f4goh/aprs-pocket/README.md

# APRS-pocket

**APRS with ATtiny1614**

The goal is to build a low-cost APRS tracker that fits inside a classic pocket format.  
Tracker configuration is done via serial communication using Google Chrome — no app installation required.

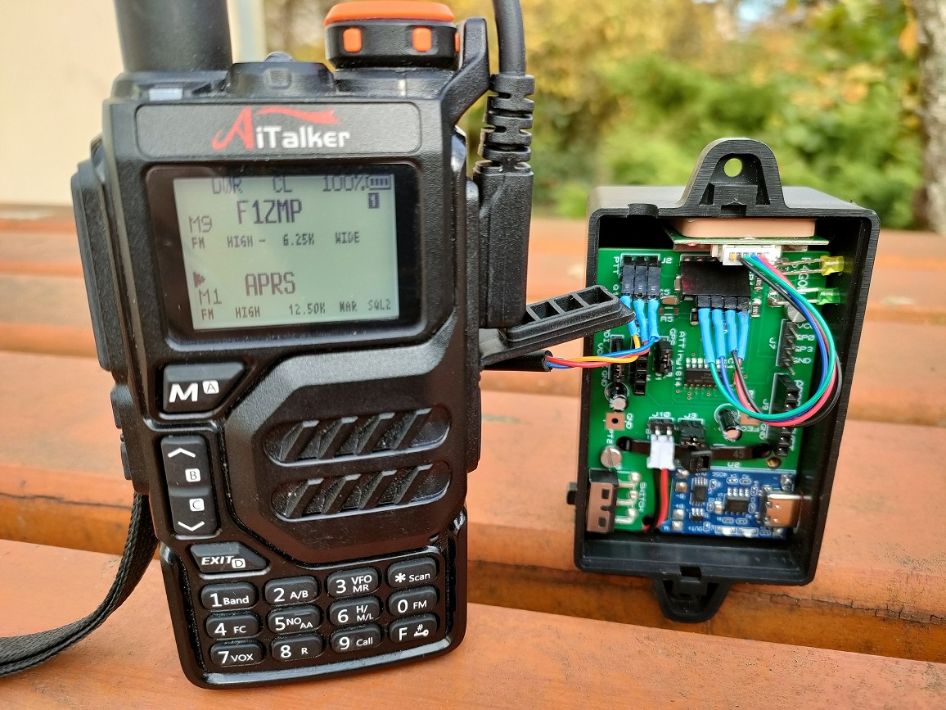
[picture p1: images/ensemble.jpg]
ens


## [APRS POCKET Setup](https://f4goh.github.io/aprs-pocket/)

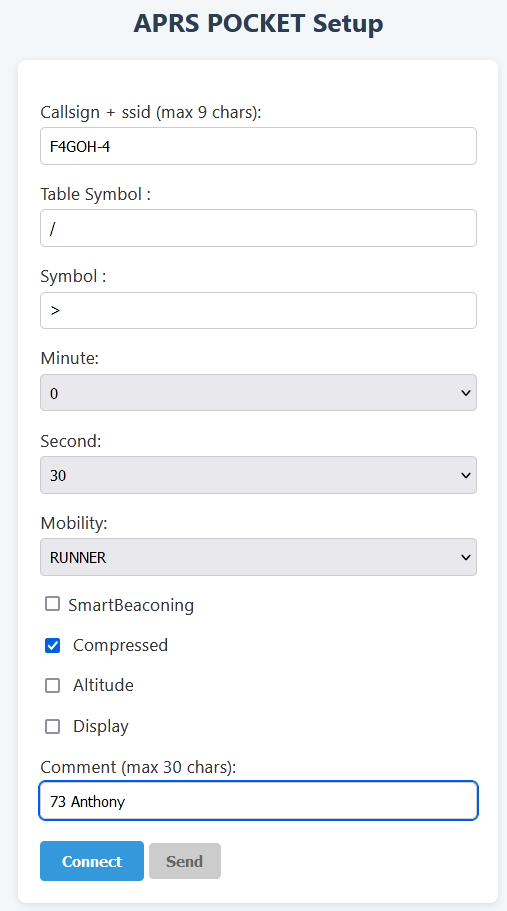
[picture p2: images/config.png]
config


## Schematic

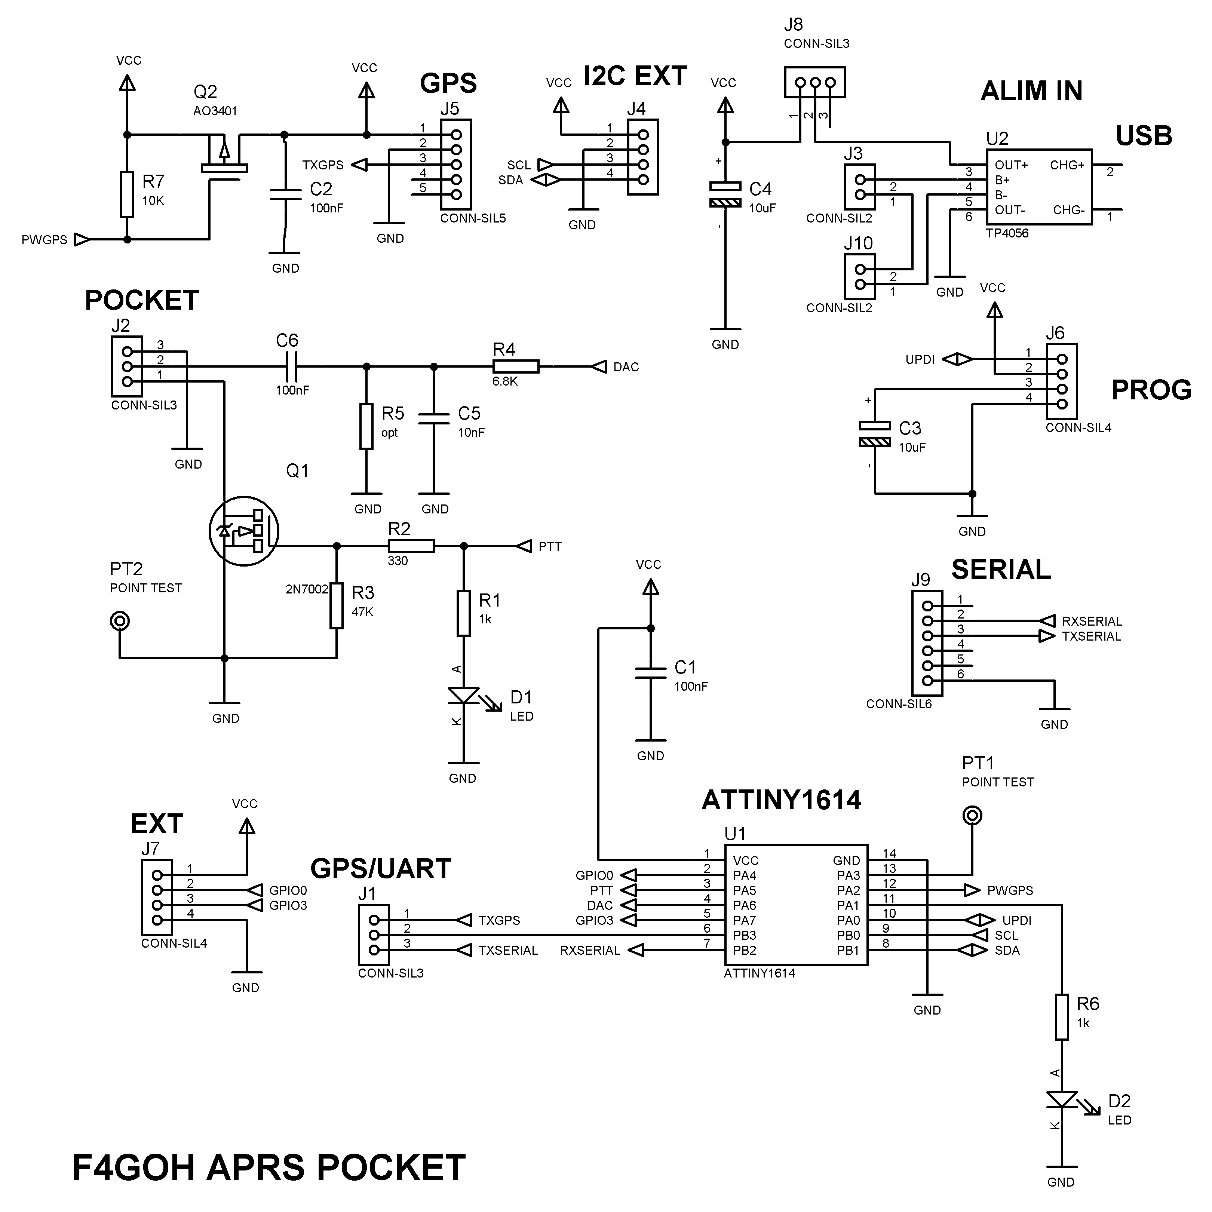
[picture p3: schematics/aprs_pocket.png]
Schematic


## BOARD

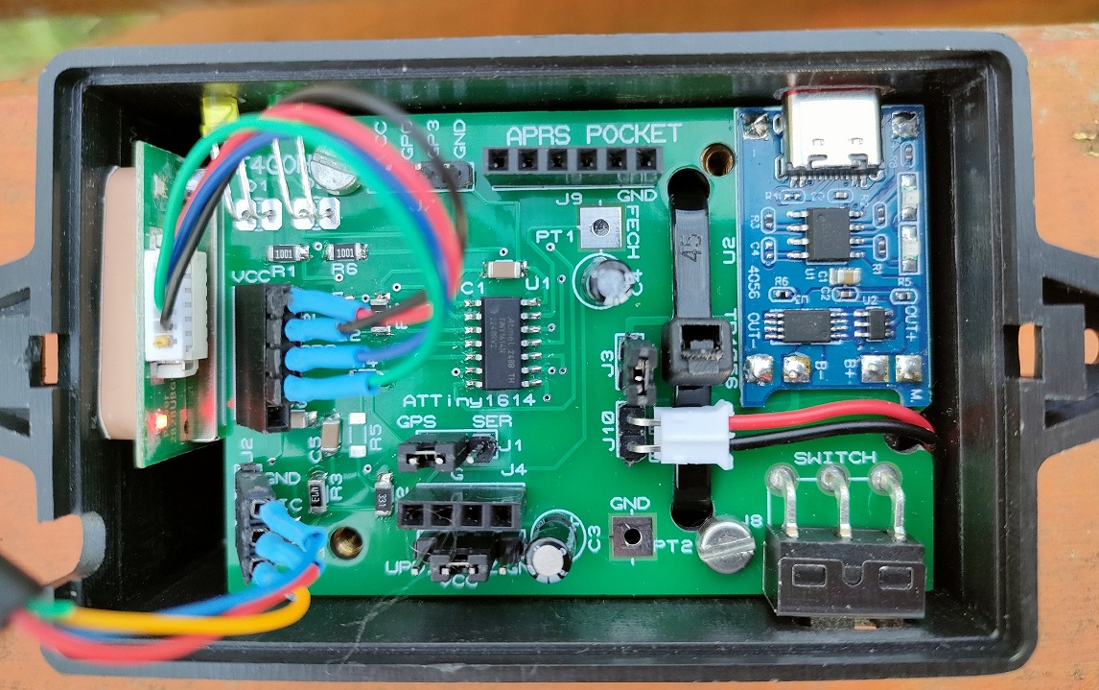
[picture p4: images/carte.jpg]
board


## PCB

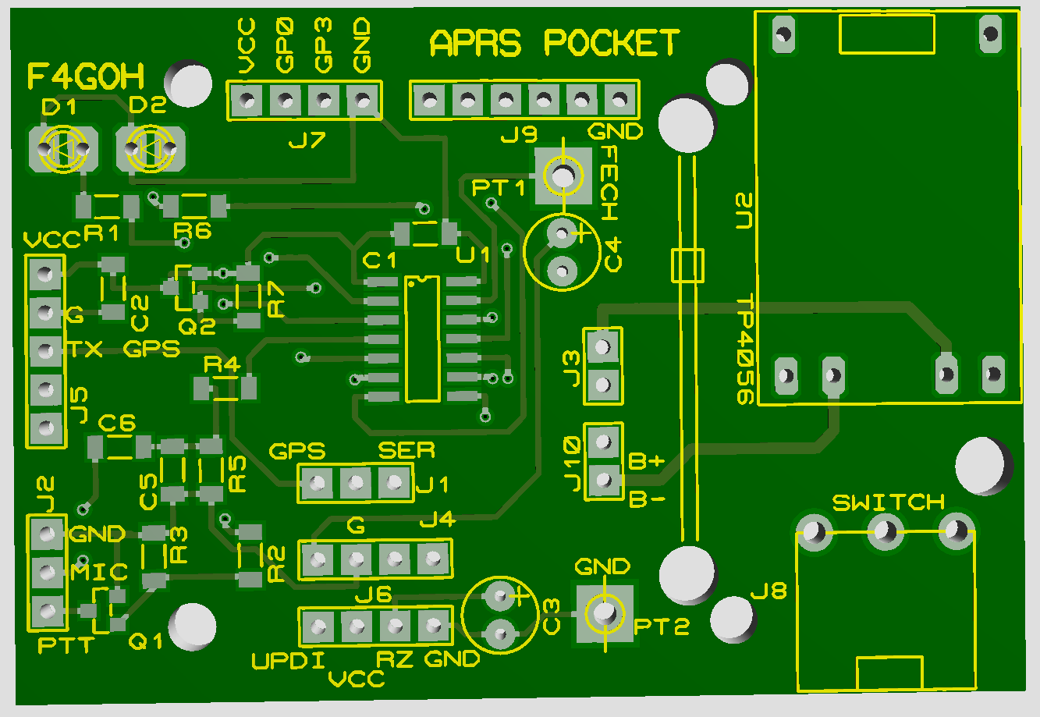
[picture p5: images/aprs-pocket-pcb.png]
aprs-pocket-pcb


## BOM

| Reference | Value | Footprint / Description | Qty |
|---|---|---|-----|
| R1,R6 | 1k | Resistor 1206 | 2 |
| R2 | 330 | Resistor 1206 | 1 |
| R3 | 47k | Resistor 1206 | 1 |
| R4 | 6.8k | Resistor 1206 | 1 |
| R5 | opt | Resistor 1206 | 1 |
| R7 | 10k | Resistor 1206 | 1 |
| C1,C2,C6 | 100nF | Capacitor 1206 | 3 |
| C3,C4 | 10uF | Capacitor vertical | 2 |
| C5 | 10nF | Capacitor  1206 | 1 |
| U1 | ATTINY1614 | Integrated Circuit SOIC 14 | 1 |
| U2 | TP4056 | Integrated Circuit module | 1 |
| Q1 | 2N7002 | Transistor sot23 | 1 |
| Q2 | AO3401 | Transistor sot23 | 1 |
| D1,D2 | LED | Diode | 2 |
| J8 | SWITCH | Switch | 1 |
| J1,J2 | CONN-SIL3 | Male Connector | 2 |
| J3,J10 | CONN-SIL2 | Male Connector | 2 |
| J4 | CONN-SIL4 | Male Connector | 1 |
| J5 | CONN-SIL5 | Female Connector | 1 |
| J6,J7 | CONN-SIL4 | Male Connector | 2 |
| J9 | CONN-SIL6 | Female Connector | 1 |
| PT1,PT2 | POINT TEST | Test Point | 2 |

## ATtiny1614 Pinout

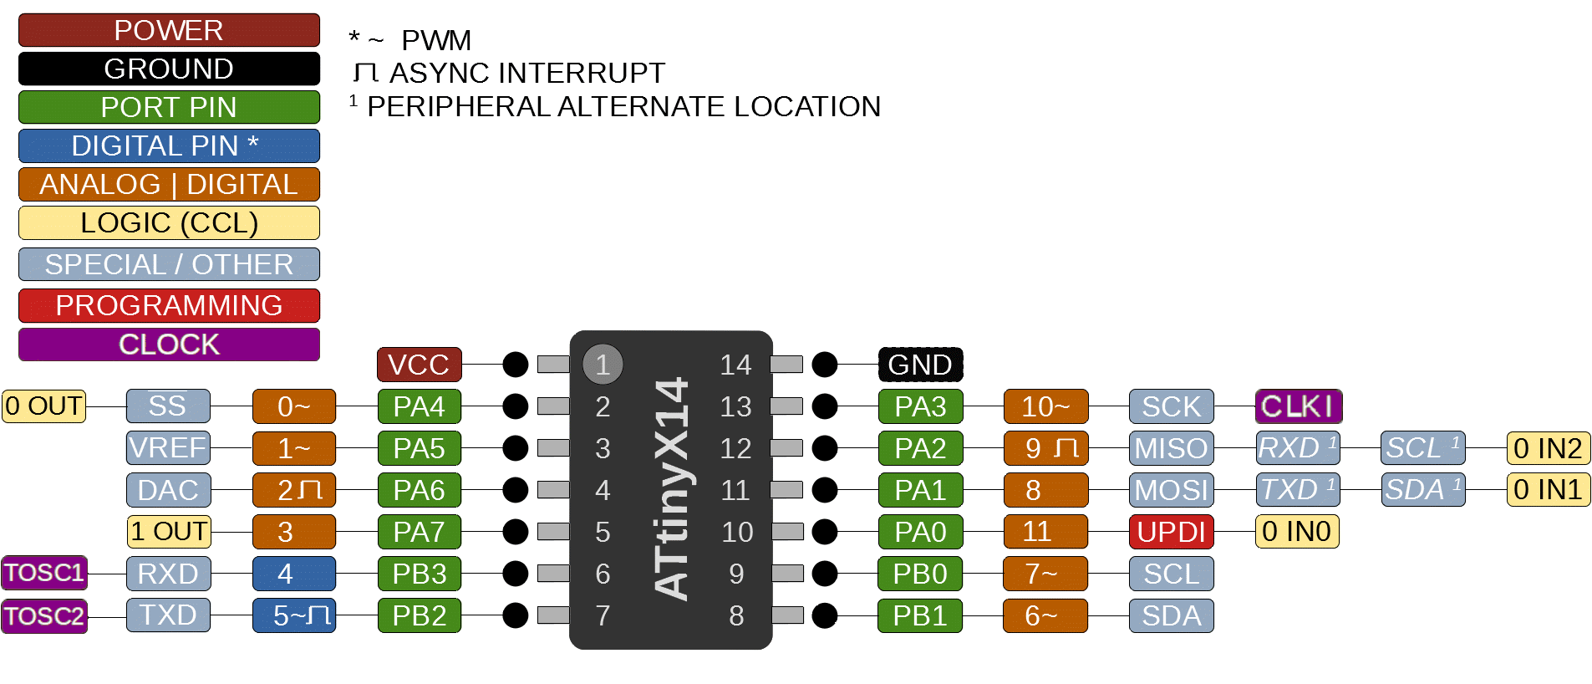
[picture p6: images/ATtiny_x14.png]
ATtiny_x14


### SpMic Pinout (colors depends of source cable)

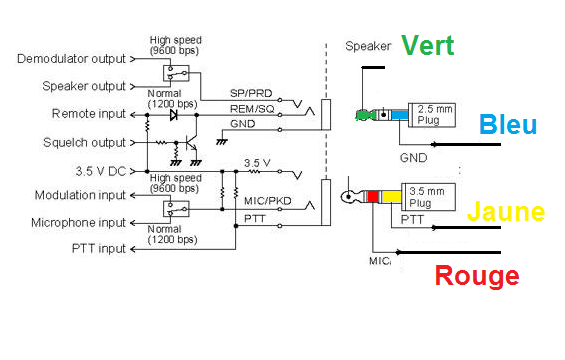
[picture p7: images/SpMic_pinout.png]
SpMic_pinout


### Testing Tracker
  
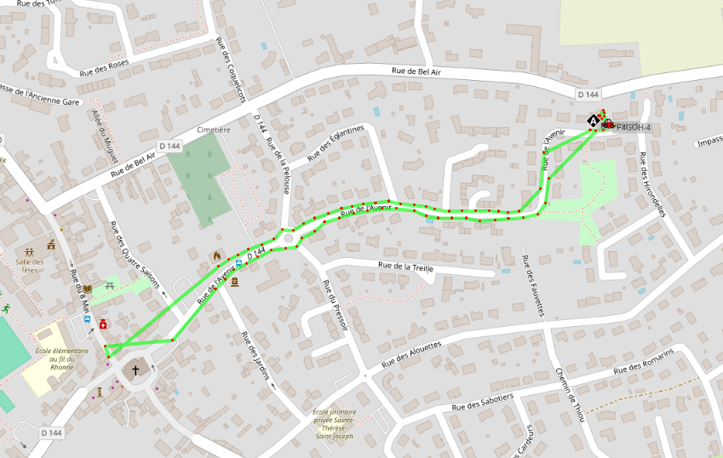
[picture p8: images/test.png]
test


### APRS symbols
  
test

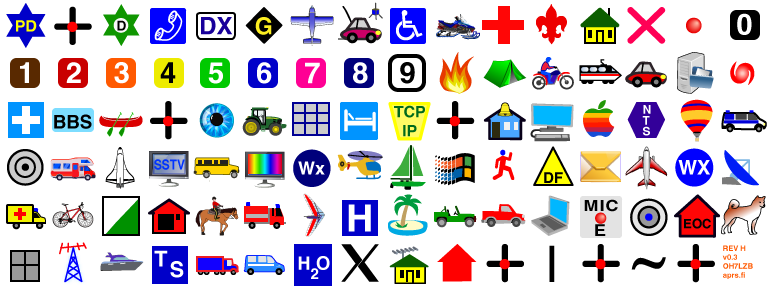
[picture p9: images/aprs-symbols-24-0@2x.png]


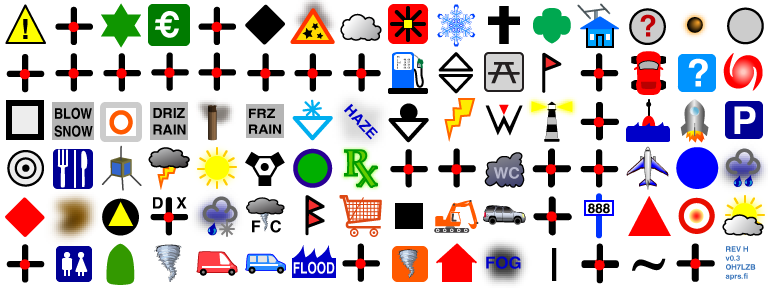
[picture p10: images/aprs-symbols-24-1@2x.png]


## Programming [ATtiny1614 with UPDI and Arduino IDE](https://www.hackster.io/john-bradnam/using-the-new-attiny-processors-with-arduino-ide-612185)

To get started with UPDI programming for the ATtiny1614 using the Arduino IDE, follow these steps:

### 1. Update board manager

This board package can be installed via the board manager. The boards manager URL is:

```console
http://drazzy.com/package_drazzy.com_index.json
```
- File -> Preferences, enter the above URL in "Additional Boards Manager URLs"
- Tools -> Boards -> Boards Manager...
- Select "megaTinyCore by Spence Konde" and click "Install".

### 2. Install megaTinyCore

Use the Board Manager in Arduino IDE to install the **megaTinyCore** package.  
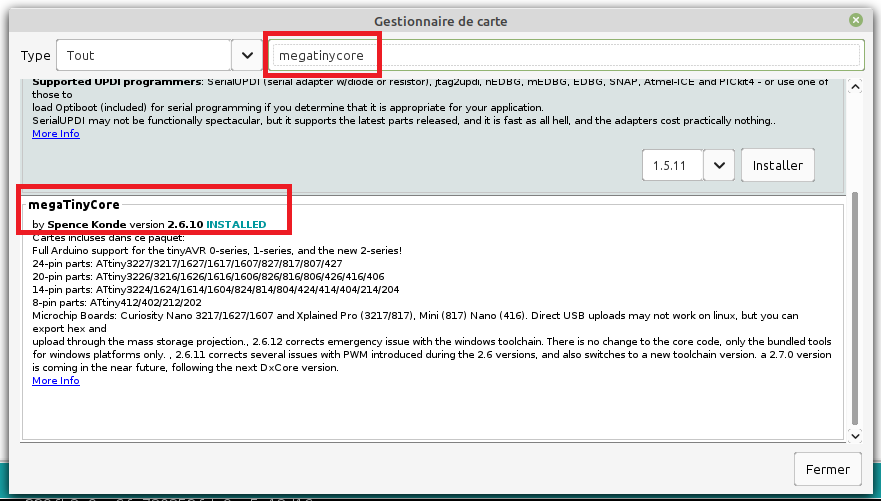
[picture p11: images/m0.png]
Install megaTinyCore


### 3. Select the ATtiny family
Choose the **ATtiny** family from the board selection menu.  
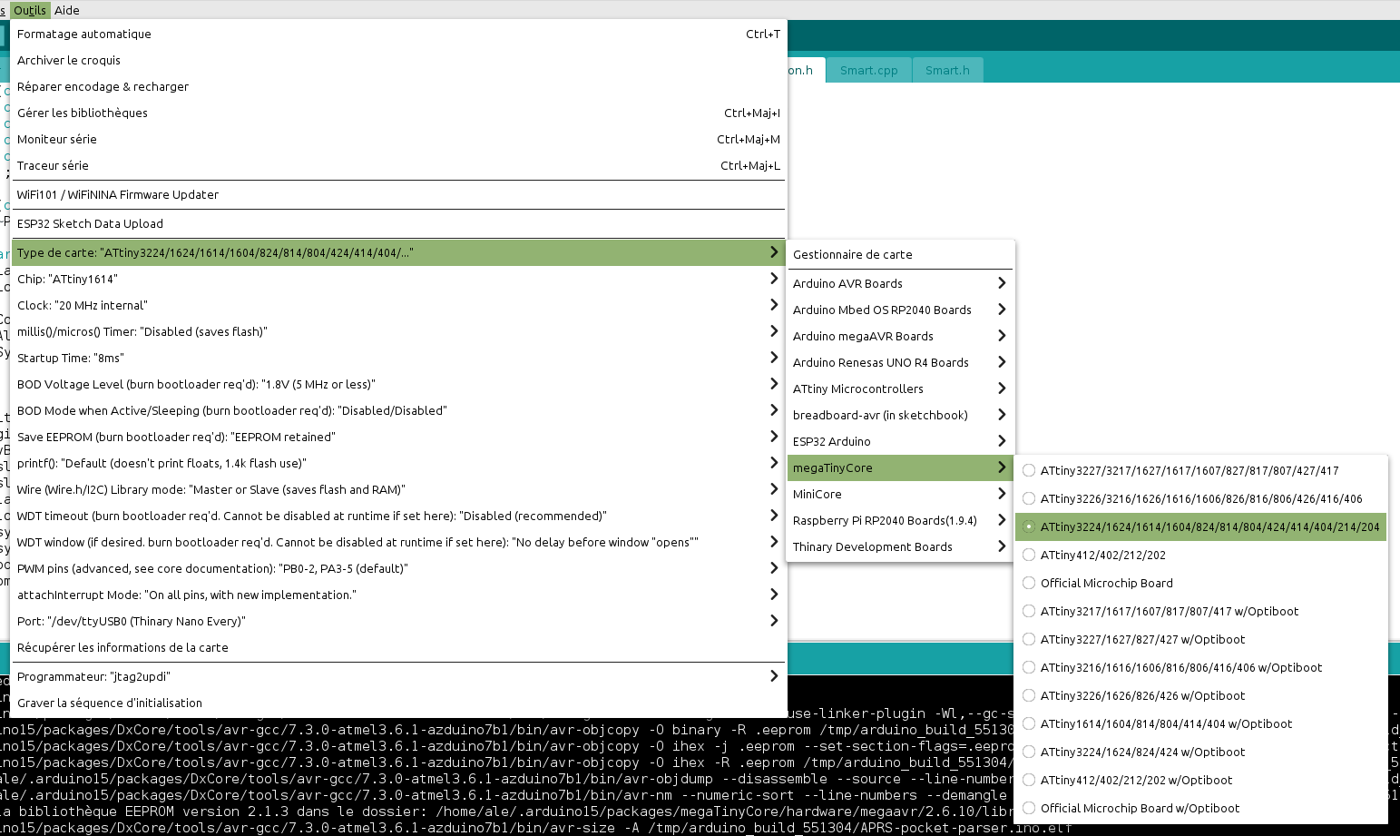
[picture p12: images/m1.png]
Select ATtiny family


### 4. Choose ATtiny1614
Pick **ATtiny1614** as your target microcontroller.  
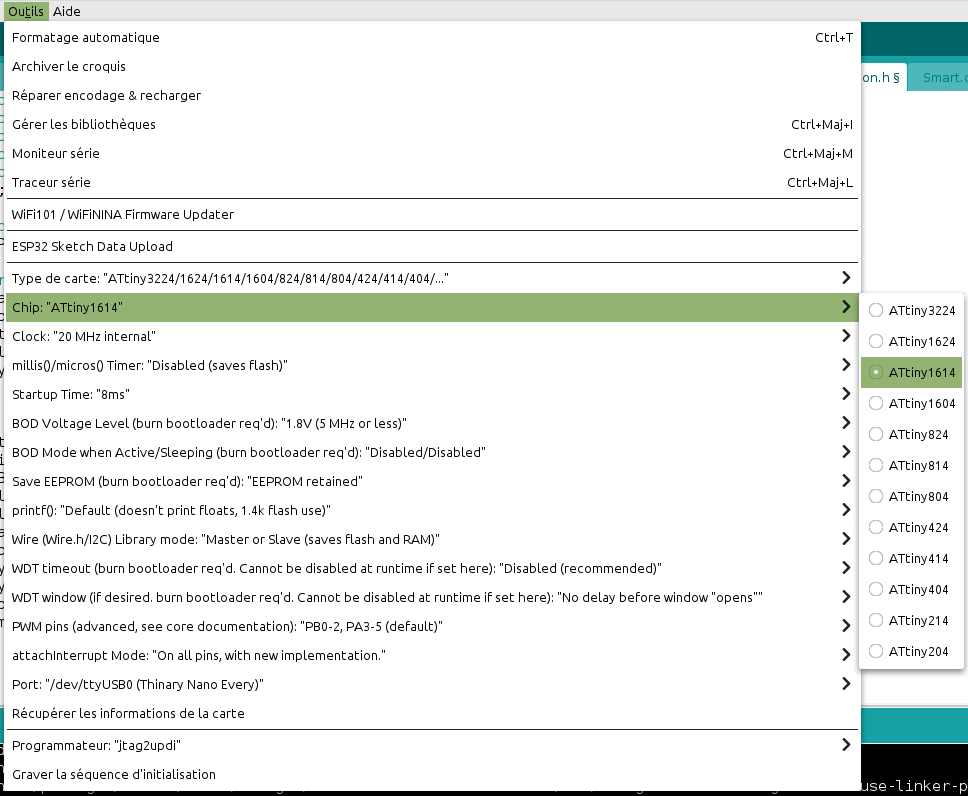
[picture p13: images/m2.png]
Select ATtiny1614


### 5. Disable unnecessary features
To optimize memory usage, disable the following options in the board settings:

- **Remove millis() support**  
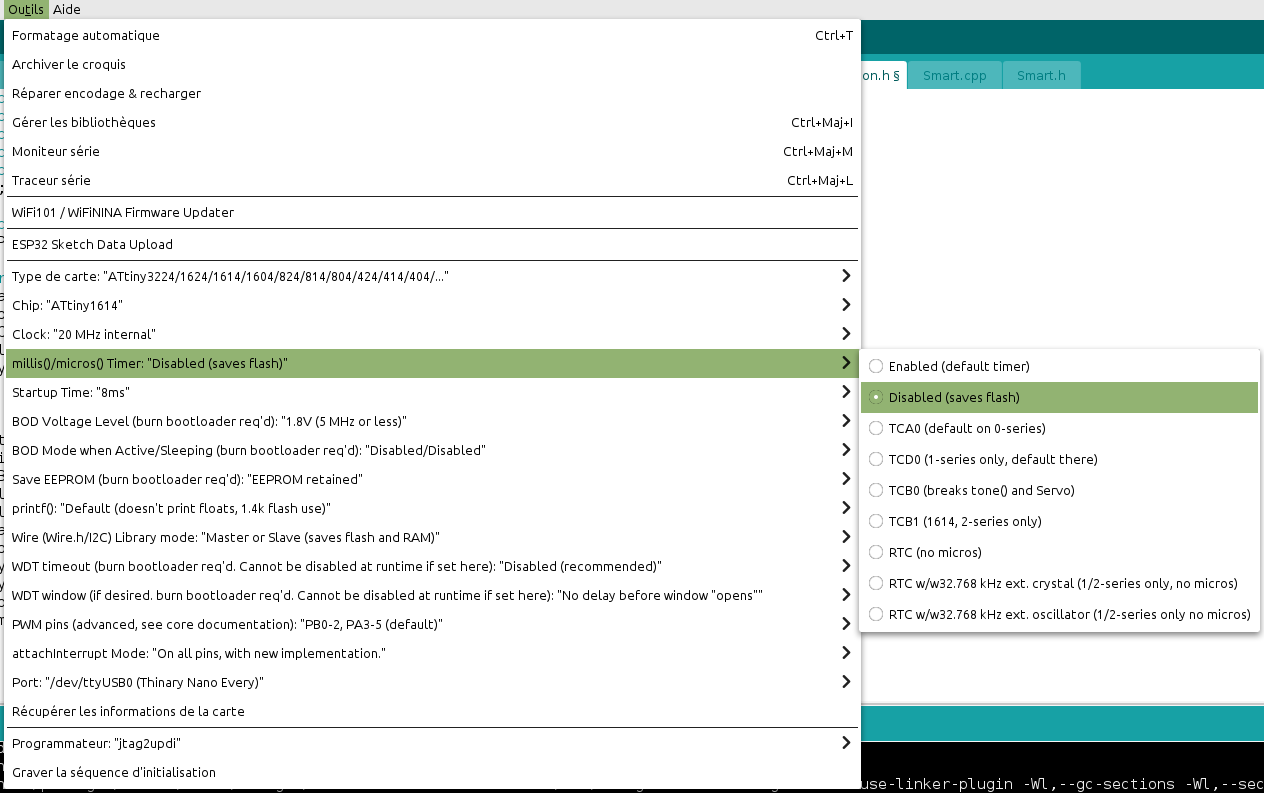
[picture p14: images/m3.png]
Remove millis
  

- **Remove float support in sprintf()**  
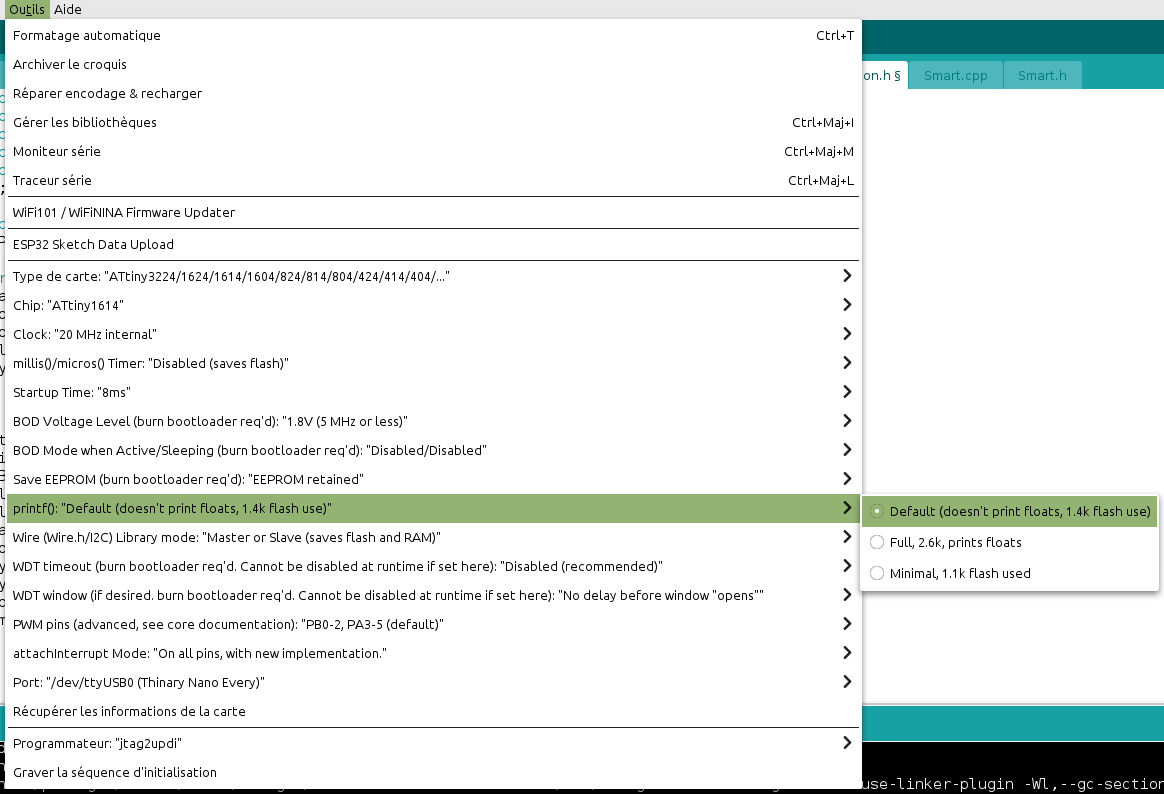
[picture p15: images/m4.png]
Remove float sprintf
  

### 6. Compile APRS-pocket-parser.ino

## Flash the firmware

UPDI (Unified Program and Debug Interface) allows programming ATtiny1614 using just one data pin. 
You need to programm jtag2udi in an Arduino uno before

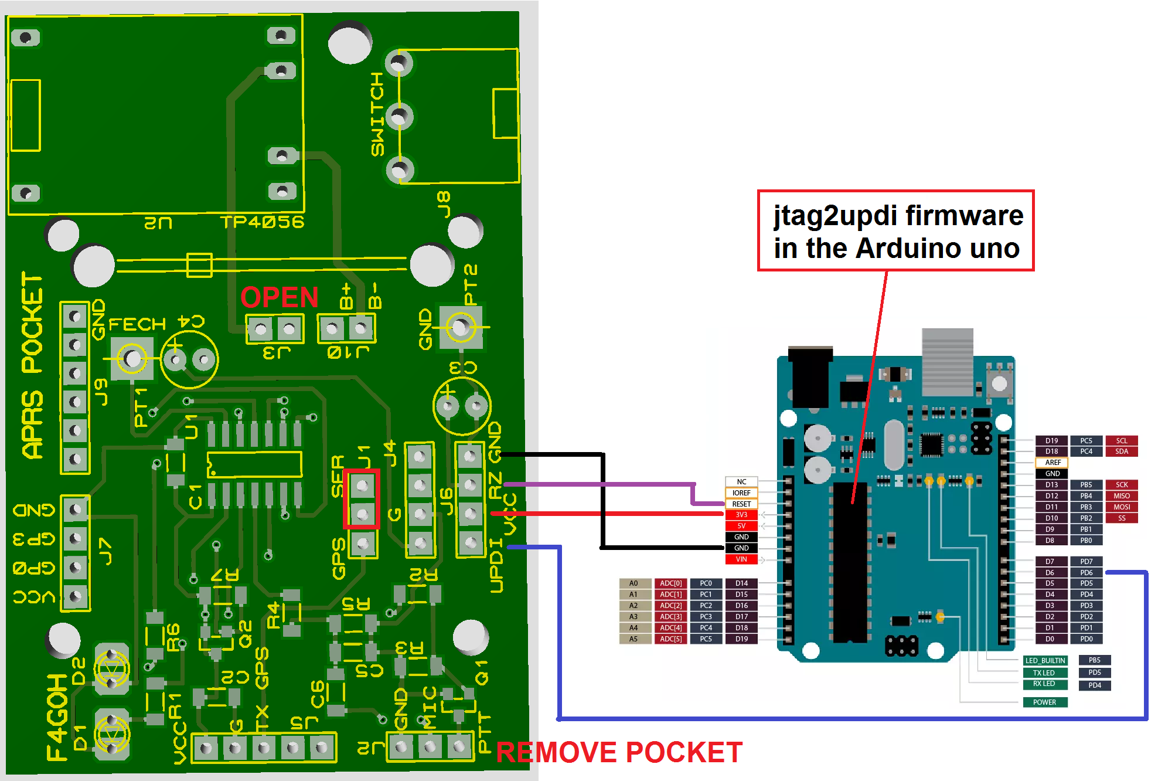
[picture p16: images/UPDI.png]
UPDI


After using the online configuration software (Google Chrome browser) to program your callsign.

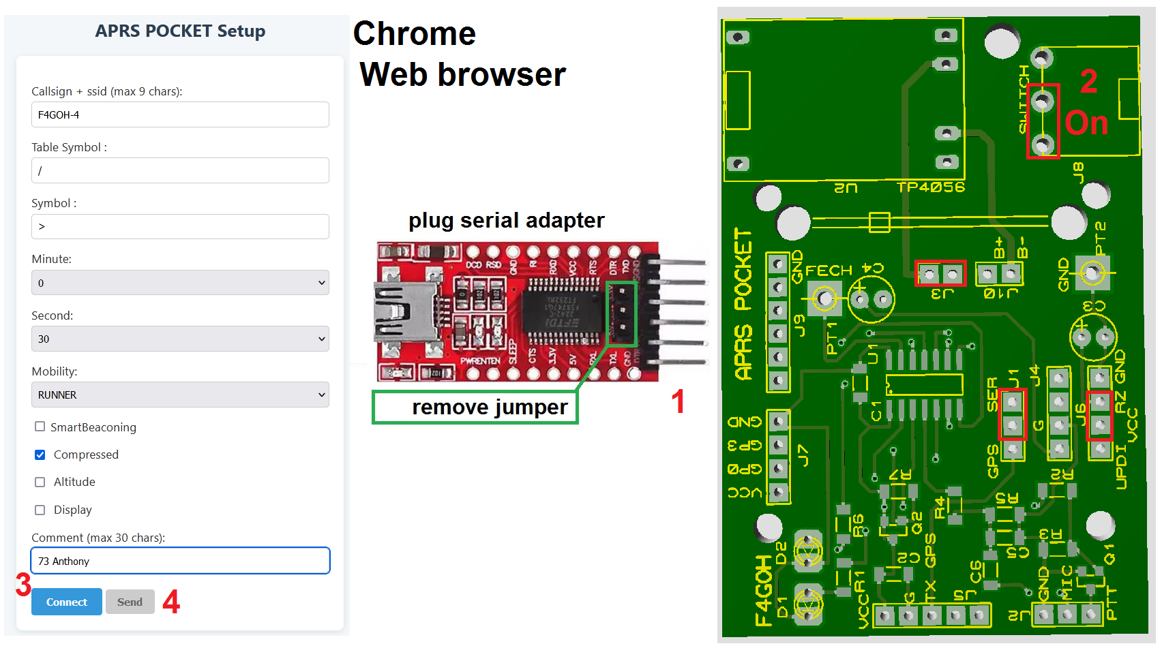
[picture p17: images/aprs-pocket-config.png]
CONFIG


Finally, place the jumper in GPS position and connect the handheld device to connector J2. LED D2 will flash once the GPS has acquired the time. LED D1 indicates PTT status during transmission.

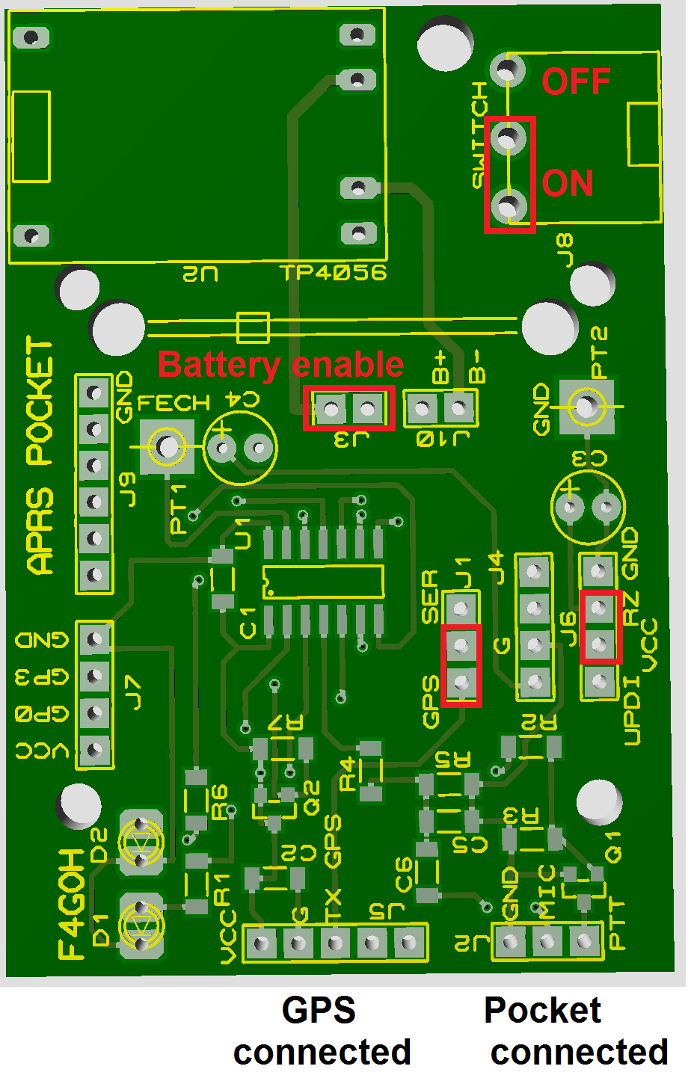
[picture p18: images/aprs-pocket-pcb-normal.png]
NORMAL


## License

**APRS Pocket** by **F4GOH** is licensed under the  
[Creative Commons Attribution-NonCommercial-ShareAlike 4.0 International (CC BY-NC-SA 4.0)](https://creativecommons.org/licenses/by-nc-sa/4.0/)
