f4goh/aprs-pocket/images/proto.jpg

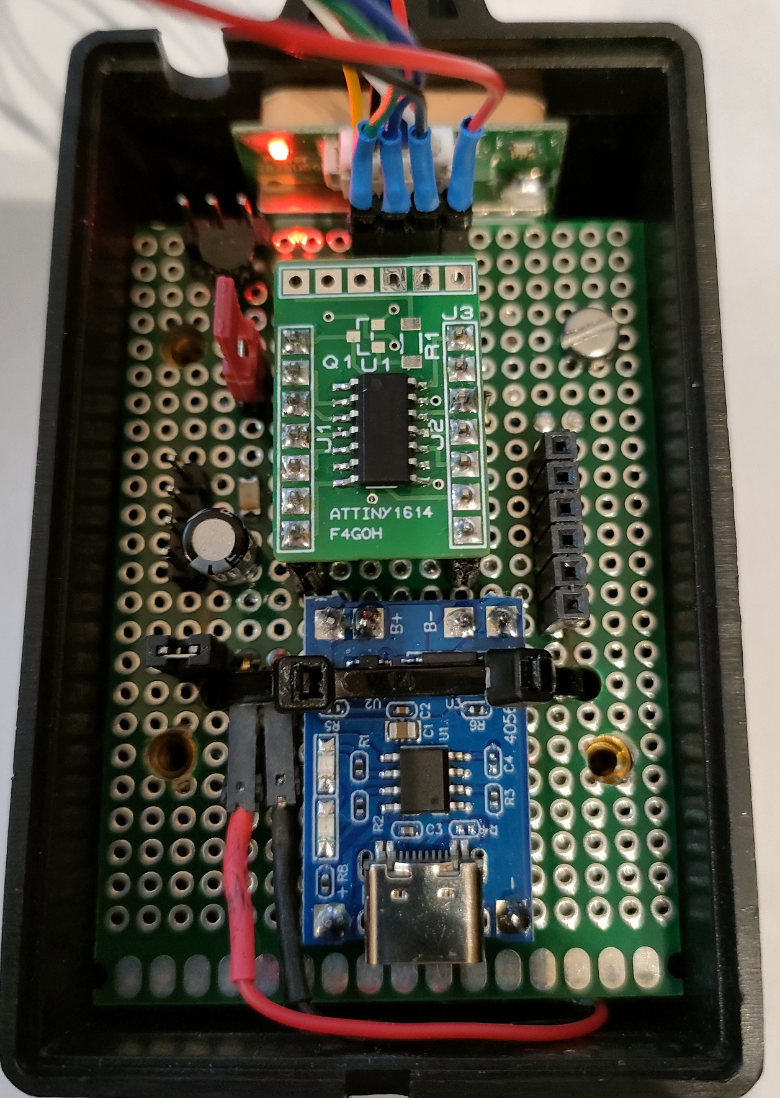
images/proto.jpg
