f4goh/aprs-pocket/APRS-pocket-parser/APRS-pocket-parser.ino

/*
  Génère un signal APRS en FSK 1200 baud sur la sortie DAC de l'ATTINY1614
  en fonction du GPS
  https://github.com/wb2osz/aprsspec
  Configuation via une page web
*/
#include <Arduino.h>
#include <EEPROM.h>
#include "Position.h"
#include "Ax25.h"
#include "Smart.h"
#include "ParserNMEA.h"


#define BITRATE 1200
#define GPSBAUD 9600
#define PTT 1
#define PWR_GPS 9
#define LED_BEAT 8


typedef struct {
  char callsign[10];
  char comment[31];
  char tableSymbol;
  char symbol;
  uint8_t minute;
  uint8_t second;
  bool smart;
  bool compressed;
  bool altitude;
  bool display;
  MobilityType mobility;
} configuration;




ParserNMEA gps;

configuration *config;

Fsk *leFsk;
Ax25 *ax25;
Position *pos;
Smart *smartBeacon;

byte second_prec = 0;
bool newData = false;

int main() {
  Serial.begin(GPSBAUD);
  pinMode(PTT, OUTPUT);
  digitalWrite(PTT, LOW);
  pinMode(PWR_GPS, OUTPUT);
  digitalWrite(PWR_GPS, LOW);
   pinMode(LED_BEAT, OUTPUT);
  digitalWrite(LED_BEAT, LOW);
  
  _PROTECTED_WRITE(CLKCTRL_MCLKCTRLB, 0);  // Horloge principale à 20 MHz

  config = new configuration;
  EEPROM.get(0, *config);
  afficheConfig();

  if (EEPROM.read(0) == 0xff) {
    strcpy(config->callsign, "F4XXX-4");
    strcpy(config->comment, "Nano");
    config->tableSymbol = '/';
    config->symbol = '>';
    config->minute = 10;
    config->second = 10;
    config->smart = false;
    config->compressed = true;
    config->altitude = false;
    config->display = false;
    config->mobility = RUNNER;
    EEPROM.put(0, *config);
  }

  pos = new Position(47.890242, 0.276770, config->comment, config->tableSymbol, config->symbol);

  leFsk = new Fsk(1200, 1000);
  ax25 = new Ax25(*leFsk);

  leFsk->begin();
  char dstCallsign[] = "F4GOH  ";
  char path1[]       = "WIDE1-1";
  char path2[]       = "WIDE2-2";
  ax25->begin(BITRATE, config->callsign, dstCallsign, path1, path2);


  smartBeacon = new Smart();


  while (1) {
    syncGps();
    //txing();
    //leFsk->delay(5000);
  }

}

void syncGps() {
  // For one second we parse GPS data and report some key values
  newData = false;
  while (Serial.available()) {
    char c = Serial.read();
    //Serial.write(c); // uncomment this line if you want to see the GPS data flowing
    if (c == '#') {
      saveConfig();
    }
    if (gps.encode(c)) // Did a new valid sentence come in?
      newData = true;
  }

  if (newData) {
    newData = false;
    if (gps.isTimeValid() && gps.getSecond() != second_prec) {
      second_prec = gps.getSecond();
      Serial.println(gps.getTime());
      digitalWrite(LED_BEAT, digitalRead(LED_BEAT) ^ 1);
      if (gps.isCoordValid()) {
        float lat = gps.getLatDec();
        float lon = gps.getLongDec();
        pos->setLatitude(lat);
        pos->setLongitude(lon);
        if (gps.isAltValid()) pos->setAltitude(gps.getAltitudeMeters());
        if (config->smart) {                     //attention pour test smart enlever le ! après le test
          int course = gps.getCourse();
          int speed = gps.getSpeed();
          smartBeacon->setMobilityType(config->mobility);  //a deporter dans la config
          smartBeacon->setMillis(leFsk->millis());
          if (gps.isSpeedValid()) smartBeacon->setSpeed(speed);
          if (gps.isCourseValid()) smartBeacon->setCourse(course);
          if (smartBeacon->isTxing()) {
            txing();
          }
        }
        else {
          if (config->minute == 0) {                      //envoi plusieurs fois par minute suivant modulo seconde
            if (gps.getSecond() % config->second == 0) {
              txing();
            }
          } else {    //envoi toute les config->minute  à la config->second
            if ((gps.getMinute() % config->minute == 0) && (gps.getSecond() == config->second)) {
              txing();
            }
          }
        }
      }
    }
  }
}




void txing() {
  //Serial.println(gps->get_latitude());
  //Serial.println(gps->get_longitude());
  //Serial.println(gps->f_speed_kmph());
  //Serial.println(gps->course());
  const char* pdu;
  digitalWrite(PTT, HIGH);   // turn the LED on ptt on
  pdu = pos->getPduAprs(config->compressed, config->altitude && gps.isAltValid());
  Serial.println(pdu);
  Serial.flush();
  ax25->txMessage(pdu);
  digitalWrite(PTT, LOW);    // turn the LED off ptt off
}




void saveConfig() {
  Serial.println("config saved");
  //Serial.println(sizeof(configuration));
  unsigned long startTime = leFsk->millis();
  while (Serial.available() < sizeof(configuration)) {
    if (leFsk->millis() - startTime > 2000) {
      Serial.println(F("⏱Serial Timeout"));
      return;
    }
  }

  size_t n = Serial.readBytes((char*)config, sizeof(configuration));

  if (n == sizeof(configuration)) {
    EEPROM.put(0, *config); //sauve
    //afficheConfig();
    digitalWrite(LED_BEAT, HIGH); //led PTT on
    leFsk->delay(1000);
    _PROTECTED_WRITE(RSTCTRL.SWRR, RSTCTRL_SWRE_bm); // Déclenche un reset logiciel pour prise en compte de la nouvelle config
  }

}


void afficheConfig()
{
  Serial.println(F("Configuration :"));
  Serial.print(F("Callsign: ")); Serial.println(config->callsign);
  Serial.print(F("Table symbol: ")); Serial.println(config->tableSymbol);
  Serial.print(F("Symbol: ")); Serial.println(config->symbol);
  Serial.print(F("Comment: ")); Serial.println(config->comment);
  Serial.print(F("Minute: ")); Serial.println(config->minute);
  Serial.print(F("SmartBeaconing: ")); Serial.println(config->smart ? "Yes" : "No");
  Serial.print(F("Compressed: ")); Serial.println(config->compressed ? "Yes" : "No");
  Serial.print(F("Altitude: ")); Serial.println(config->altitude ? "Yes" : "No");
  Serial.print(F("Display: ")); Serial.println(config->display ? "Yes" : "No");
  Serial.print(F("Mobility: "));
  switch (config->mobility) {
    case 0 :  Serial.println(F("RUNNER"));
      break;
    case 1 :  Serial.println(F("BIKE"));
      break;
    case 2 :  Serial.println(F("CAR"));
      break;
  }
}


/*
  //tempo sans irq
  void delay_s(byte sec) {
  for (byte s = 0; s < sec; s++) {
    for (uint32_t n = 0; n < 2800000UL; n++) {
      __asm__ __volatile__("nop");
    }
  }
  }
*/
