f4goh/aprs-pocket/APRS-pocket-parser/Position.cpp

/*
   File:   Position.cpp
   Author: philippe & Anthony

   Created on 7 août 2021, 08:00
*/

#include "Position.h"

/**

   @param _latitude
   @param _longitude      double longitude
   @param _comment        String le commentaire
   @param _symboleTable   char pour désigner la table des symboles
   @param _symbole        char pour désigner un symbole dans la table
*/
Position::Position(const float _latitude, const float _longitude, char * _comment, const char _symboleTable, const char _symbole) :
  latitude(_latitude),
  longitude(_longitude),
  symboleTable(_symboleTable),
  symbole(_symbole),
  altitude(0)
{
  comment = _comment;
  trimTrailingSpaces(comment);
}

Position::Position(const Position& orig) {
}

Position::~Position() {
}

void Position::setLatitude(const float _latitude) {
  latitude = _latitude;
}

void Position::setLongitude(const float _longitude) {
  longitude = _longitude;
}

void Position::setComment(char  *_comment) {
  comment = _comment;
  trimTrailingSpaces(comment);
}

void Position::setSymbol(char _symbole) {
  symbole = _symbole;
}


void Position::setAltitude(const float _alt) {
  altitude = (uint32_t)(3.2809 * _alt);
}

/**
   @brief Fabrique le PDU APRS position
          si compressed est true la position est compressée (base91)
   @param bool compressed indique si la position doit être compressée
   @return char* Le pdu APRS position
*/
const char* Position::getPduAprs(bool compressed, bool altEnable) {
  char com[50];
  char salt[10];

  memset(salt, '\0', 10);
  memset(com, '\0', 50);

  snprintf(alt91, sizeof(alt91), "  G");
  
  if (altEnable) {
    if (!compressed) {
      snprintf(salt, sizeof (salt), "/A=%06d", altitude);
      strcat(com, salt);
    }
    else {
      if (altitude > 0) {
        altitude_APRS_comp();
      }
    }
  }
  strcat(com, comment);

  if (compressed) {

    latitude_to_comp_str();
    longitude_to_comp_str();


    snprintf(pdu, sizeof (pdu), "!%c%s%s%c%s%s", symboleTable, slat, slong, symbole, alt91, com);
  }
  else {
    latitude_to_str();
    longitude_to_str();
    snprintf(pdu, sizeof (pdu), "!%s%c%s%c%s", slat, symboleTable, slong, symbole, com);
  }
  return pdu;
}


void Position::latitude_to_str() {
  float latAbs = fabs(latitude);
  char hemi = (latitude < 0.0) ? 'S' : 'N';

  int deg = (int)latAbs;
  float min = (latAbs - deg) * 60.0;

  // Arrondi manuel à 2 décimales
  int minInt = (int)min;
  int minFrac = (int)((min - minInt) * 100 + 0.5);

  // Gestion du cas 59.995 → 60.00
  if (minFrac == 100) {
    minFrac = 0;
    minInt++;
    if (minInt == 60) {
      minInt = 0;
      deg++;
    }
  }

  // Format final : ddmm.mmN → 8 caractères
  snprintf(slat, sizeof(slat), "%02d%02d.%02d%c", deg, minInt, minFrac, hemi);
}

// exemple char trameAPRS[] = "!4753.41N/00016.61E>test";


void Position::longitude_to_str() {
  float longAbs = fabs(longitude);
  char hemi = (longitude < 0.0) ? 'W' : 'E';

  int deg = (int)longAbs;
  float min = (longAbs - deg) * 60.0;

  // Arrondi manuel à 2 décimales
  int minInt = (int)min;
  int minFrac = (int)((min - minInt) * 100 + 0.5);

  // Gestion du cas 59.995 → 60.00
  if (minFrac == 100) {
    minFrac = 0;
    minInt++;
    if (minInt == 60) {
      minInt = 0;
      deg++;
    }
  }

  // Format final : dddmm.mmE → 9 caractères
  snprintf(slong, sizeof(slong), "%03d%02d.%02d%c", deg, minInt, minFrac, hemi);
}


void Position::altitude_APRS_comp() {

  int x = static_cast<int> (log((float) altitude) / 0.001998003);
  alt91[0] = (x / 91) + 33;
  alt91[1] = (x % 91) + 33;
  alt91[2] = 'S';
  alt91[3] = '\0';
}


void Position::latitude_to_comp_str() {

  int32_t y;
  y = (int32_t) round(380926. * (90. - latitude));
  convBase91(y, slat);
}

void Position::longitude_to_comp_str() {

  int32_t x;
  x = (int32_t) round(190463. * (180. + longitude));
  convBase91(x, slong);
}

void Position::convBase91(int32_t x, char* base91) {

  //int c[4];

  for (int i = 3; i >= 0; i--) {
    base91[i] = (x % 91) + 33;
    x /= 91;
  }
  base91[4] = '\0';
}

void Position::trimTrailingSpaces(char *str) {
  int len = strlen(str);
  while (len > 0 && str[len - 1] == ' ') {
    str[--len] = '\0';
  }
}
